cataphract26/Perancangan-Sistem-Biomedis-/Poster PSB NEKO-AIR.png

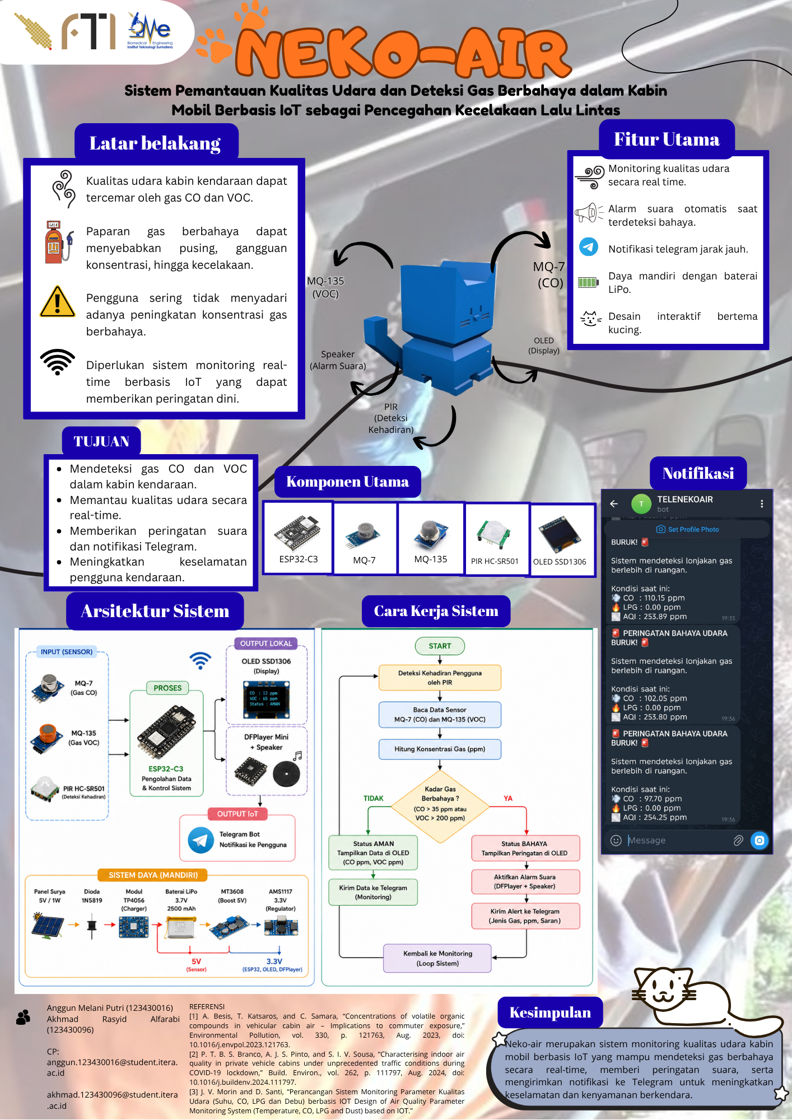
Poster PSB NEKO-AIR.png
