cataphract26/Perancangan-Sistem-Biomedis-/Dokumentasi/WhatsApp Image 2026-10-28 at 18.26.33(1).jpeg

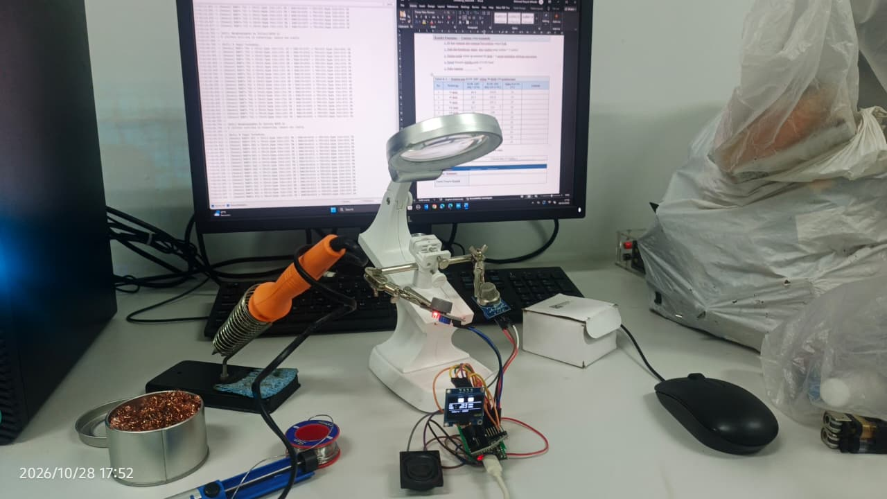
Dokumentasi/WhatsApp Image 2026-10-28 at 18.26.33(1).jpeg
