cataphract26/Perancangan-Sistem-Biomedis-/README.md

# Perancangan-Sistem-Biomedis-
Repo ini berisi kodingan, dokumentasi proyek, data, desain, dan prosedur kerja yang relevan dengan proyek yang dikerjakan. Proyek yang dikerjakan adalah NEKO-Air, sistem pemantau udara di dalam kabin mobil.

Anda dipersilakan mengambil kodingan hingga design dari repo ini. Namun, alangkah baiknya untuk menghubungi email pemilik terlebih dahulu sebelum menggunakan repo ini. alamat email:

rasyidwaykanan123@gmail.com
