cataphract26/Perancangan-Sistem-Biomedis-/Hasil Lembar Prosedur Pengujian .docx

K-1 · KALIBRASI BASELINE UDARA BERSIH (R₀)

Tujuan: Menetapkan nilai ADC acuan sensor di udara bersih sebelum semua pengujian dimulai.

Kondisi Pengujian — Centang yang terpenuhi
| | □ Di luar ruangan atau ruangan berventilasi sangat baik
| | □ Jauh dari kendaraan, dapur, atau sumber asap (radius > 5 meter)
| | □ Sistem sudah warm-up minimal 60 detik + 5 menit tambahan sebelum pencatatan
| | ☒ Serial Monitor terbuka pada 115200 baud
| | ☒ Suhu ruangan: 25 °C

Tabel K-1 — Pembacaan nilai terhitung (indeks) setiap 30 detik (10 pembacaan)
No. | Waktu ke- | Indeks MQ-7 (CO) | Indeks MQ-135 (VOC) | Suhu Saat Itu (°C) | Catatan
1 | 30 detik | 18,4 | 250,9 | 25
2 | 60 detik | 24,7 | 251,6 | 25
3 | 90 detik | 20 | 251,2 | 25
4 | 120 detik | 22,7 | 251 | 25
5 | 150 detik | 23 | 256 | 25
6 | 180 detik | 21,5 | 253,8 | 25
7 | 210 detik | 20,8 | 252,6 | 25
8 | 240 detik | 20,9 | 252,9 | 25
9 | 270 detik | 20,3 | 250,9 | 25
10 | 300 detik | 22,9 | 250,7 | 25
RATA-RATA (R₀) | | 21,52 | 252,16 | 25 | σ CO = 1,83 σ VOC = 1,70

Nilai R₀ yang ditetapkan setelah perhitungan rata-rata:

R₀ MQ-7 (CO) = 21,52 (indeks) | R₀ MQ-135 (VOC) = 252,16 (indeks)

Hasil Pengujian | ☒ LULUS □ TIDAK LULUS
Catatan / Komentar | Pembacaan stabil selama 5 menit: σ CO = 1,83 dan σ VOC = 1,70 (satuan indeks), jauh di bawah threshold (35 dan 300). Baseline ditetapkan: CO 21,52; VOC 252,16. Nilai berupa indeks terhitung dari kode (bukan ppm terkalibrasi).
Tanda Tangan Penguji

K-2 · KALIBRASI RESPONS BERTINGKAT (UJI JARAK)

Tujuan: Membuktikan respons sensor bersifat monoton — semakin dekat sumber gas, semakin tinggi nilai ADC.

Bahan yang digunakan

□ Sumber gas MQ-7 : Asap korek api kayu / lilin yang baru ditiup

□ Sumber gas MQ-135: Kapas dengan 3 tetes hand sanitizer / alkohol isopropil

□ Durasi paparan per percobaan: tepat 10 detik

□ Interval antar percobaan: 2 menit (tunggu sensor kembali ke R₀)

Tabel K-2A — Sensor MQ-7 (CO) — Sumber: asap korek api / lilin (nilai indeks)
Level | Jarak | Uji 1 | Uji 2 | Uji 3 | Rata-rata | Naik dari baseline (Δ)
0 | Udara bersih (baseline) | 23,2 | 22 | 36,9 | 27,4 | — (acuan)
1 | 10 cm | 86,3 | 29,5 | 36 | 50,6 | Ya, +23,2
2 | 5 cm | 135,4 | 120,2 | 68 | 107,9 | Ya, +80,5
3 | 2 cm | 156,2 | 166 | 115,2 | 145,8 | Ya, +118,4
4 | Langsung (0 cm) | 176,9 | 180 | 178 | 178,3 | Ya, +150,9
Kesimpulan: Nilai meningkat secara monoton dari Level 0 → Level 4? | | | | | | ☒ Ya □ Tidak

Tabel K-2B — Sensor MQ-135 (VOC) — Sumber: kapas alkohol (nilai indeks)
Level | Jarak | Uji 1 | Uji 2 | Uji 3 | Rata-rata | Naik dari baseline (Δ)
0 | Udara bersih (baseline) | 250,5 | 256,5 | 256 | 254,3 | — (acuan)
1 | 10 cm | 261,1 | 256,8 | 256,6 | 258,2 | Ya, +3,8 (dalam noise)
2 | 5 cm | 265,5 | 268 | 257 | 263,5 | Ya, +9,2
3 | 2 cm | 275 | 263,2 | 272 | 270,1 | Ya, +15,7
4 | Langsung (0 cm) | 302,1 | 303,5 | 301 | 302,2 | Ya, +47,9
Kesimpulan: Nilai meningkat secara monoton dari Level 0 → Level 4? | | | | | | ☒ Ya □ Tidak

Hasil Pengujian | ☒ LULUS □ TIDAK LULUS
Catatan / Komentar | Rata-rata kedua sensor naik monoton dari Level 0 ke Level 4 (dinilai dari kolom rata-rata). MQ-7: Δ +23,2 → +150,9; MQ-135: Δ +3,8 → +47,9. Catatan: (1) MQ-135 Level 1 (+3,8) masih dalam noise baseline (σ ≈ 3,3), respons jelas baru pada ≤ 2 cm; pada ulangan ke-2 Level 3 (263,2) < Level 2 (268). (2) MQ-7 ulangan ke-3: baseline (36,9) > Level 1 (36,0), diduga sisa asap percobaan sebelumnya. (3) MQ-7 juga bereaksi terhadap uap alkohol dan asap mempengaruhi kedua sensor, sehingga uji ini membuktikan responsivitas, bukan selektivitas gas.
Tanda Tangan Penguji

U-1 · UJI PRESISI SENSOR (REPEATABILITY)

Tujuan: Membuktikan sensor menghasilkan nilai konsisten untuk stimulus identik. Kriteria lulus: presisi ≥ 85%.

Protokol stimulus — WAJIB SERAGAM setiap percobaan

• Kapas yang sama dengan 3 tetes alkohol isopropil (untuk MQ-135)

• Jarak: 2 cm dari lubang ventilasi sensor

• Durasi paparan: tepat 10 detik (gunakan timer)

• Interval antar percobaan: 2 menit (tidak boleh lebih cepat)

• Untuk MQ-7: asap korek api kayu yang sama, selalu 5 cm dari sensor, 10 detik

Tabel U-1 — 10 Kali Pengulangan (nilai indeks puncak dari Serial Monitor)
No. | Indeks Puncak MQ-7 | Indeks Puncak MQ-135 | Catatan
1 | 91 | 257
2 | 97 | 259
3 | 146 | 277
4 | 122 | 265
5 | 102 | 267
6 | 73 | 268
7 | 101 | 271
8 | 105 | 279
9 | 134 | 285
10 | 113 | 316 | Pencilan (Grubbs)
Rata-rata (x̄) | 108,4 | 274,4 | Hitung: x̄ = Σ/10
Std. Deviasi (s) | 21,26 | 17,02 | s = √(Σ(xi−x̄)²/(n−1))
Presisi (%) | 80,4 % | 93,8 % | Presisi = (1 − s/x̄) × 100%
Lulus? (≥ 85%) | □ Ya ☒ Tidak | ☒ Ya □ Tidak

Hasil Pengujian | □ LULUS ☒ TIDAK LULUS

Catatan / Komentar

Simpangan baku memakai n−1; hasil lulus/tidak sama bila memakai n. MQ-7: presisi 80,4% (< 85%) → tidak lulus; stimulus asap korek dilakukan manual sehingga jarak/arah/kepekatan sulit seragam. MQ-135: presisi 93,8% → lulus. Catatan: (1) indeks MQ-135 memuat offset baseline ±252, sehingga s/x̄ tampak kecil; terhadap respons di atas baseline (Δ rata-rata ±22) simpangan 17,0 masih besar. (2) Ulangan ke-10 (316) pencilan (Grubbs G = 2,44 > 2,29); tanpa pencilan presisi MQ-135 = 96,6%. (3) Nilai MQ-135 cenderung naik antar ulangan (257 → 316), diduga akumulasi uap alkohol/drift baseline (dugaan, belum diverifikasi).
Tanda Tangan Penguji

U-2 · UJI WAKTU RESPONS NOTIFIKASI TELEGRAM

Tujuan: Memvalidasi notifikasi Telegram terkirim < 30 detik. Kriteria lulus: rata-rata < 30 detik, semua percobaan < 60 detik.

Persiapan

□ WiFi terhubung — pastikan log "[WiFi] ✓ IP: ..." muncul di Serial Monitor

□ Telegram Bot sudah aktif dan notifikasi smartphone diaktifkan

□ Dua orang: satu pegang sumber gas + stopwatch, satu pegang smartphone

□ Sistem dalam MODE STANDBY sebelum setiap percobaan

□ SSID WiFi yang digunakan: ___________________________

□ Kekuatan sinyal WiFi (RSSI dari Serial Monitor): _______ dBm

Tabel U-2 — Waktu Respons (10 Percobaan)
No. | Indeks CO saat trigger | Indeks VOC saat trigger | Waktu Respons (detik) | < 30 detik? | Notif. isi benar?
1 | 175,15 | 309,42 | 1 | ☒ Ya □ Tidak | □ Ya □ Tidak
2 | 120,65 | 308,97 | 2 | ☒ Ya □ Tidak | □ Ya □ Tidak
3 | 125,45 | 304,92 | 1 | ☒ Ya □ Tidak | □ Ya □ Tidak
4 | 131,45 | 312,57 | 3 | ☒ Ya □ Tidak | □ Ya □ Tidak
5 | 161,55 | 319,59 | 2 | ☒ Ya □ Tidak | □ Ya □ Tidak
6 | 130,9 | 305,28 | 1 | ☒ Ya □ Tidak | □ Ya □ Tidak
7 | 139,95 | 301,32 | 1 | ☒ Ya □ Tidak | □ Ya □ Tidak
8 | 131,85 | 312,12 | 2 | ☒ Ya □ Tidak | □ Ya □ Tidak
9 | 126,3 | 302,04 | 3 | ☒ Ya □ Tidak | □ Ya □ Tidak
10 | 150,8 | 303,57 | 3 | ☒ Ya □ Tidak | □ Ya □ Tidak
x̄ | 139,405 | 307,98 | 1,9 | % < 30 detik: | 100% (10/10)
Lulus? (rata-rata < 30 detik) | | | ☒ Ya □ Tidak

Hasil Pengujian | ☒ LULUS □ TIDAK LULUS
Catatan / Komentar | Waktu respons rata-rata 1,9 detik (maks. 3 detik; resolusi stopwatch 1 detik), memenuhi kriteria < 30 detik dan < 60 detik per percobaan. Titik awal: status ALERT/DANGER muncul di Serial Monitor; titik akhir: notifikasi tiba di smartphone, sehingga tidak termasuk waktu difusi gas ke sensor. Indeks CO saat trigger (120–175) jauh di atas threshold 35, menunjukkan sumber uji mempengaruhi kedua sensor sekaligus.
Tanda Tangan Penguji

U-3 · UJI FALSE ALARM RATE (60 MENIT)

Tujuan: Membuktikan sistem tidak salah memicu DANGER saat udara bersih. Kriteria lulus: ≤ 1 false alarm per 60 menit.

Kondisi Pengujian

□ Ruangan normal, tidak ada sumber gas, tidak ada rokok / dupa / wewangian kuat

□ Sistem dalam MODE STANDBY sepanjang pengujian (jangan trigger PIR)

□ Serial Monitor dan Telegram dipantau aktif

□ Waktu mulai: ____________ Waktu selesai: ____________

Tabel U-3 — Log False Alarm (isi jika terjadi false alarm)
No. | Waktu Kejadian | ppm CO | ppm VOC | Dugaan Penyebab
1
2
3
4
5
Total False Alarm dalam 60 menit: | | | | [isi dari log Serial/Telegram]
Lulus? (≤ 1 false alarm) | | | | □ Ya □ Tidak

Tabel U-3B — Pemantauan Nilai Indeks Berkala (setiap 10 menit)
No. | Menit ke- | Indeks CO | Indeks VOC | Status Mode
1 | 10 | 18,2 | 272,3
2 | 20 | 17,5 | 271,2
3 | 30 | 17,9 | 274,3
4 | 40 | 17,3 | 272,8
5 | 50 | 14,8 | 273,9
6 | 60 | 14,3 | 276,3

Hasil Pengujian | □ LULUS □ TIDAK LULUS
Catatan / Komentar | Pada 6 titik pantau (menit 10–60) indeks CO = 14,3–18,2 (< 35) dan indeks VOC = 271,2–276,3 (< 300): tidak ada nilai di atas threshold. Kelulusan menunggu konfirmasi jumlah false alarm dari log Serial Monitor/Telegram selama 60 menit. Catatan: indeks VOC ±20 lebih tinggi dari baseline K-1 (252,2) dan margin ke threshold tinggal ±24, sehingga risiko false alarm nyata; diduga drift baseline/sisa uap alkohol dari uji sebelumnya (dugaan).
Tanda Tangan Penguji

REKAP HASIL SELURUH PENGUJIAN

Kode | Jenis | Nama Pengujian | Kriteria Lulus | Hasil
K-1 | Kalibrasi | Baseline Udara Bersih (R₀) | Rata-rata 10 pembacaan stabil | ☒ LULUS □ TIDAK
K-2 | Kalibrasi | Respons Bertingkat (Monoton) | Nilai naik Level 0 → Level 4 | ☒ LULUS □ TIDAK
U-1 | Keandalan | Presisi Sensor | Presisi ≥ 85% | □ LULUS MQ-135 93,8%)(MQ-7 80,4%; ☒ TIDAK
U-2 | Keandalan | Waktu Respons Telegram | Rata-rata < 30 detik | ☒ LULUS □ TIDAK
U-3 | Keandalan | False Alarm Rate | ≤ 1 false alarm / 60 menit | □ LULUS □ TIDAK (konfirmasi log)
U-4 | Keandalan | State Machine (5 Siklus) | Lulus ≥ 4 dari 5 siklus | TIDAK DILAKUKAN (keterbatasan waktu)
U-5 | Keandalan | Ketahanan Baterai | Durasi operasi ≥ 6 jam | TIDAK DILAKUKAN (keterbatasan waktu)
U-6 | Keandalan | Stabilitas Tegangan | +5V dan +3,3V dalam toleransi | TIDAK DILAKUKAN (keterbatasan waktu)
KESIMPULAN KESELURUHAN | | | | □ LULUS ☒ REVISI

Catatan Umum / Rekomendasi Perbaikan

1. Cakupan pengujian. Dilaksanakan: K-1, K-2, U-1, U-2, dan U-3 (pemantauan 6 titik selama 60 menit). U-4 (state machine), U-5 (ketahanan baterai), dan U-6 (stabilitas tegangan daya) belum dilaksanakan karena keterbatasan waktu dan diajukan sebagai pekerjaan lanjutan.

2. Temuan utama. Baseline stabil (σ CO 1,83; σ VOC 1,70). Respons kedua sensor naik monoton terhadap kedekatan sumber gas. Waktu respons notifikasi Telegram rata-rata 1,9 detik (maks. 3 detik), memenuhi < 30 detik. Presisi MQ-135 = 93,8% (lulus), presisi MQ-7 = 80,4% (tidak lulus, < 85%).

3. Keterbatasan. Tanpa alat referensi, nilai berupa indeks relatif (bukan ppm); hasil menunjukkan konsistensi dan responsivitas, bukan akurasi absolut. Kedua sensor bersifat cross-sensitive (MQ-7 ikut bereaksi terhadap uap alkohol; asap mempengaruhi keduanya) sehingga selektivitas gas tidak terbukti. Stimulus diberikan manual sehingga variasi jarak dan kepekatan besar.

4. Drift baseline. Indeks VOC pada U-3B (271–276) lebih tinggi dari baseline K-1 (252,2); margin ke threshold VOC 300 tinggal ±24 sehingga rentan false alarm. Disarankan baseline diambil ulang setiap sesi dan sensor dinyalakan (burn-in) ≥ 24 jam sebelum pengujian.

5. Rekomendasi. (a) Standarkan stimulus dengan wadah/jig tertutup dan volume tetap, lalu ulangi U-1 untuk MQ-7; (b) lengkapi U-4, U-5, dan U-6; (c) kalibrasi absolut dengan detektor CO terstandar pada pengembangan lanjutan; (d) sesuaikan threshold terhadap noise dan drift baseline hasil karakterisasi ini.
