cataphract26/Perancangan-Sistem-Biomedis-/Diagram/Diagram Alir NEKO AIR (PNG).png

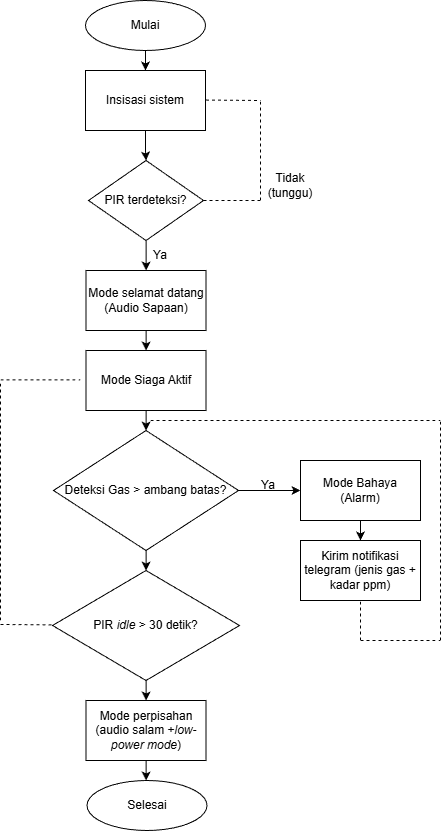
Diagram/Diagram Alir NEKO AIR (PNG).png
