cataphract26/Perancangan-Sistem-Biomedis-/Diagram/Diagram Blok NEKO AIR (PNG).png

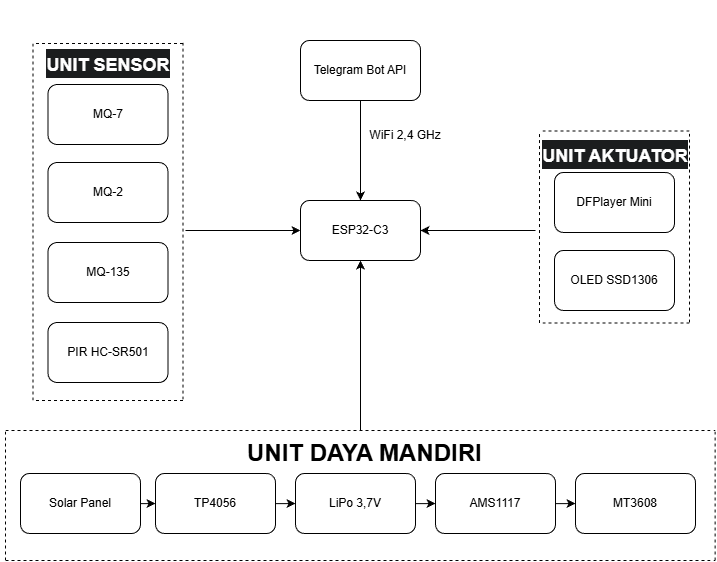
Diagram/Diagram Blok NEKO AIR (PNG).png
