cataphract26/Perancangan-Sistem-Biomedis-/Diagram/diagram blok.png

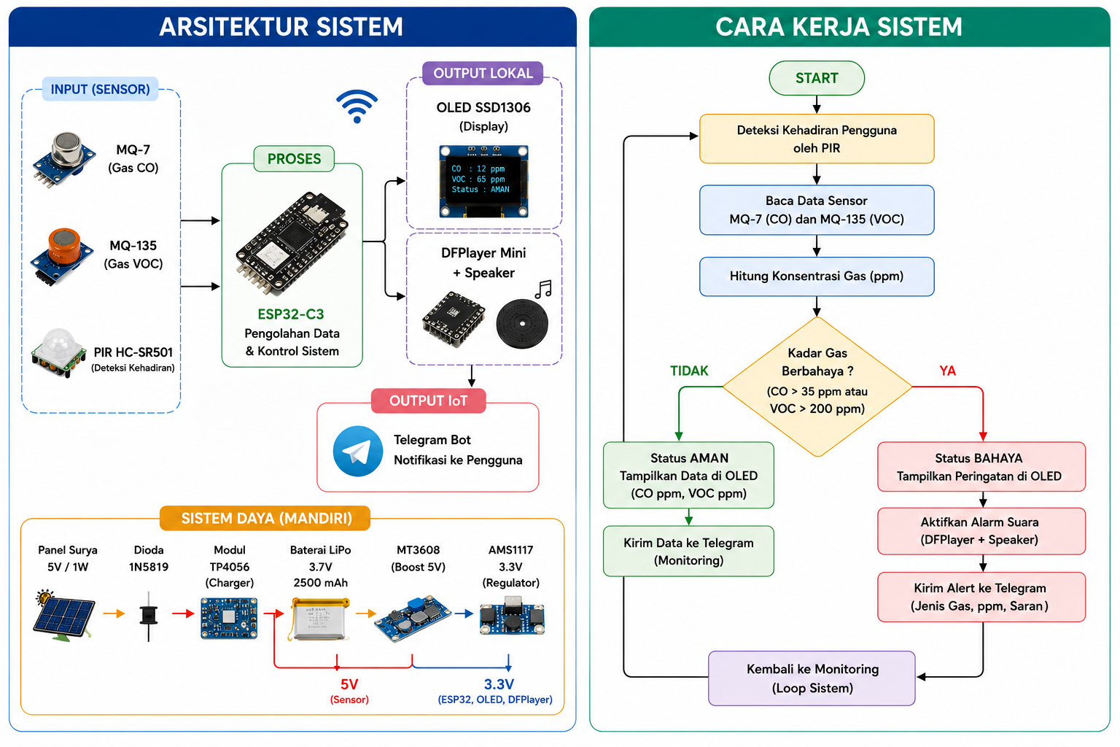
Diagram/diagram blok.png
