cataphract26/Perancangan-Sistem-Biomedis-/Design/PCB_PCB_PSB-NEKO-AIR_2026-10-30.pdf

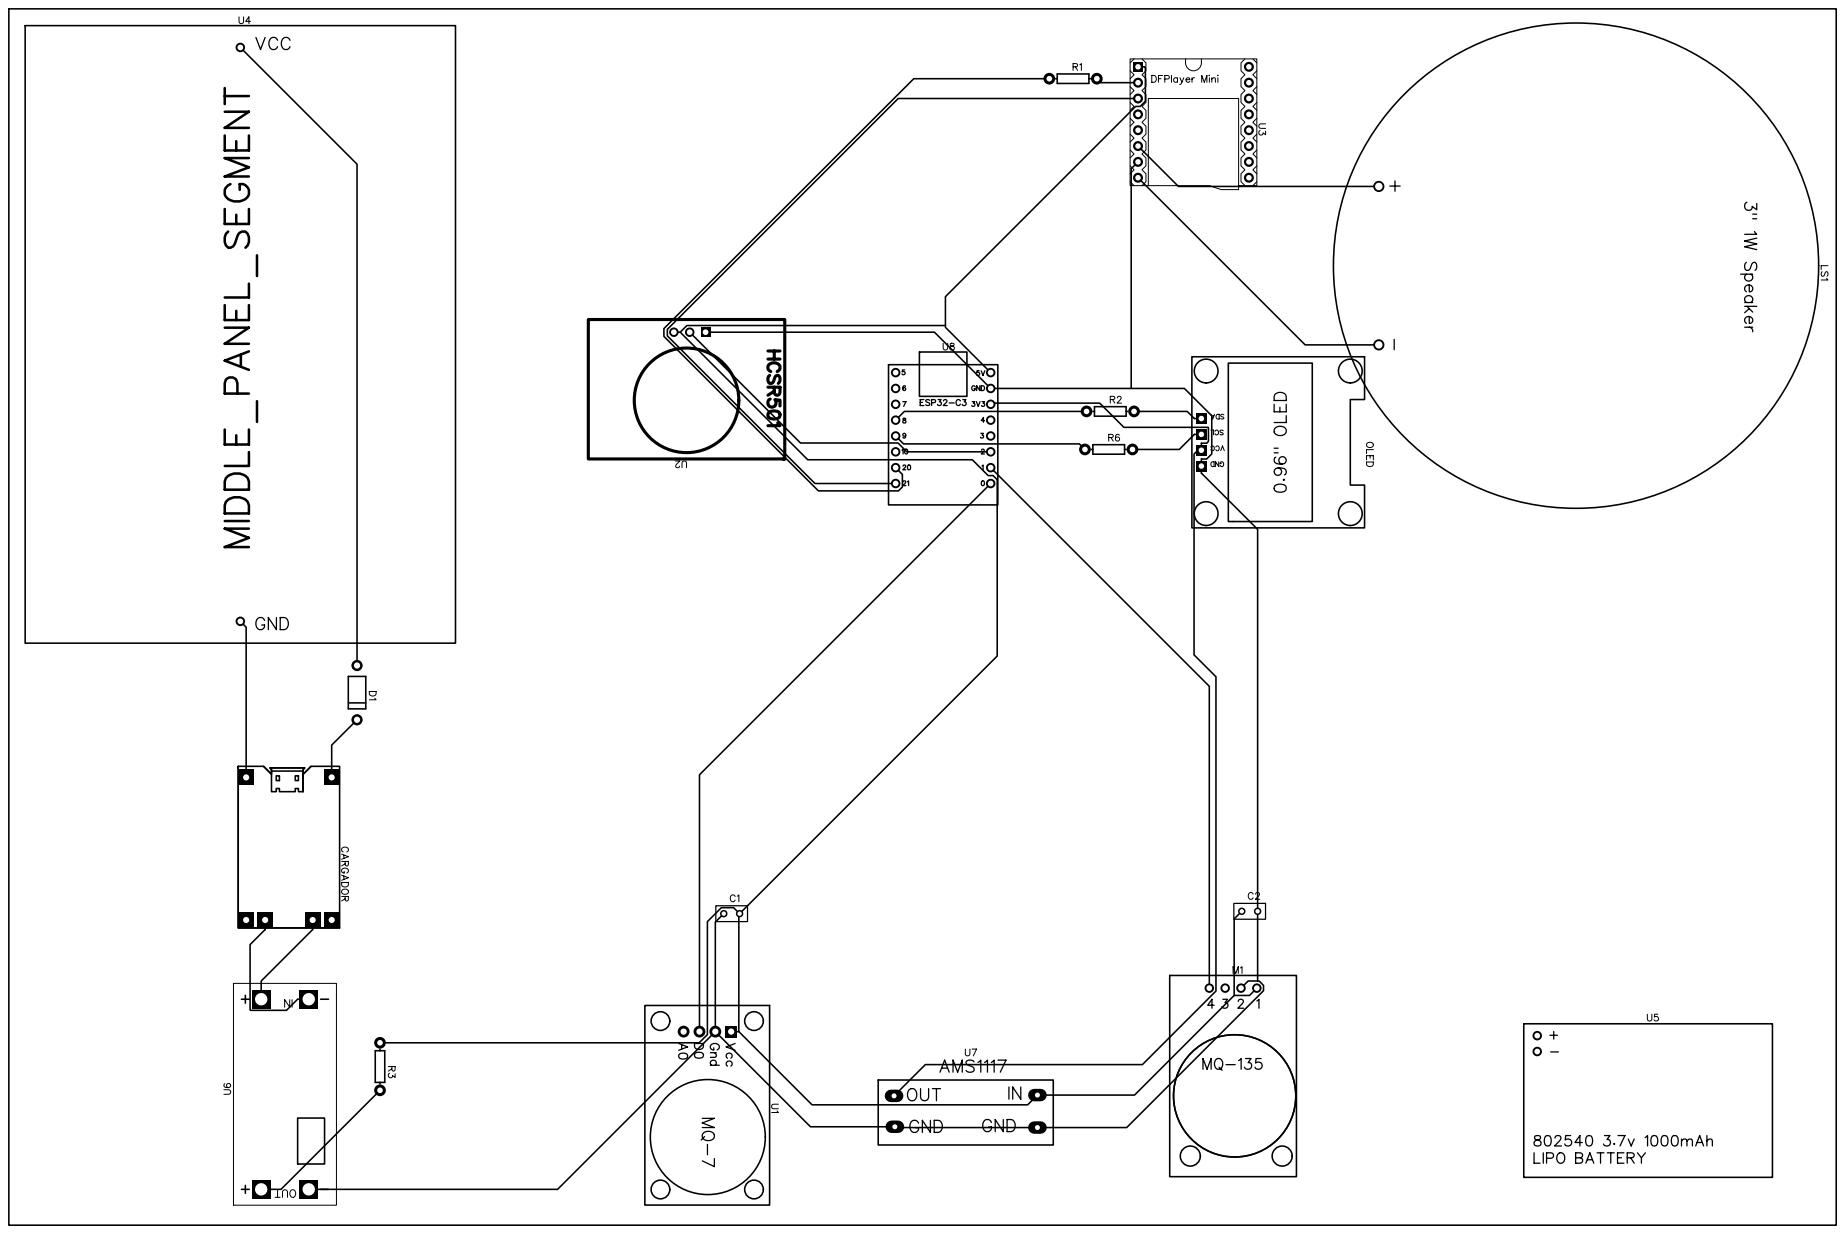
[picture p7: page 1]
