cataphract26/Perancangan-Sistem-Biomedis-/Design/Schematic_PSB-NEKO-AIR_2026-10-30.pdf

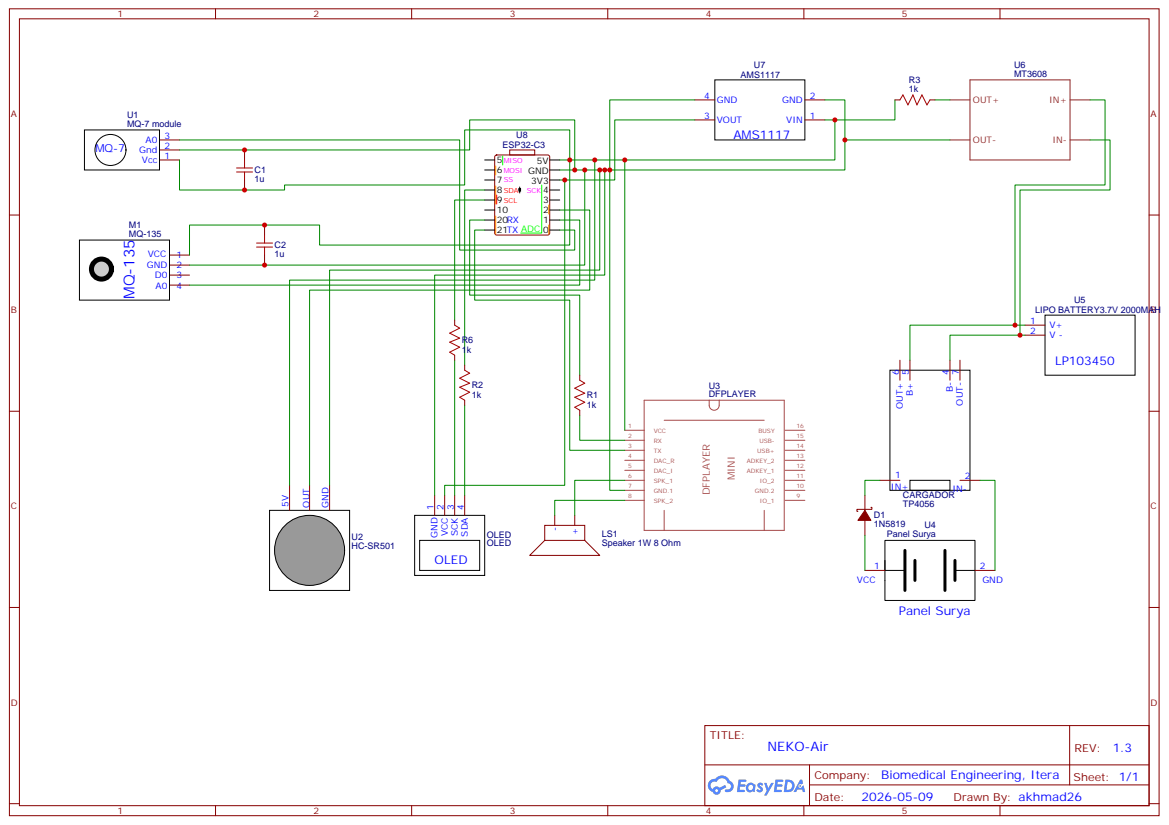
[picture p8: page 1]

Company: Biomedical Engineering, Itera
